kronovi24/Automated-Emergency-Power-Supply-Using-Solar-Energy-/Web app/panel/assets/img/emergency.png

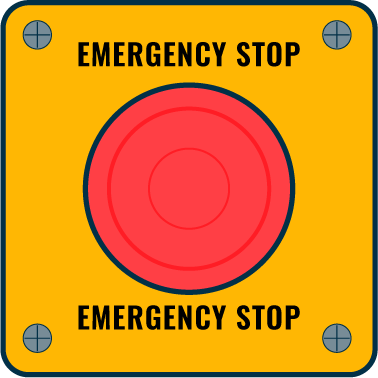
Web app/panel/assets/img/emergency.png
