kronovi24/Automated-Emergency-Power-Supply-Using-Solar-Energy-/Web app/panel/assets/img/smiley.jpg

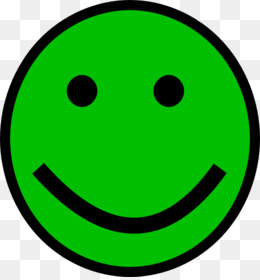
Web app/panel/assets/img/smiley.jpg
