kronovi24/Automated-Emergency-Power-Supply-Using-Solar-Energy-/Web app/panel/assets/img/swith2.jpg

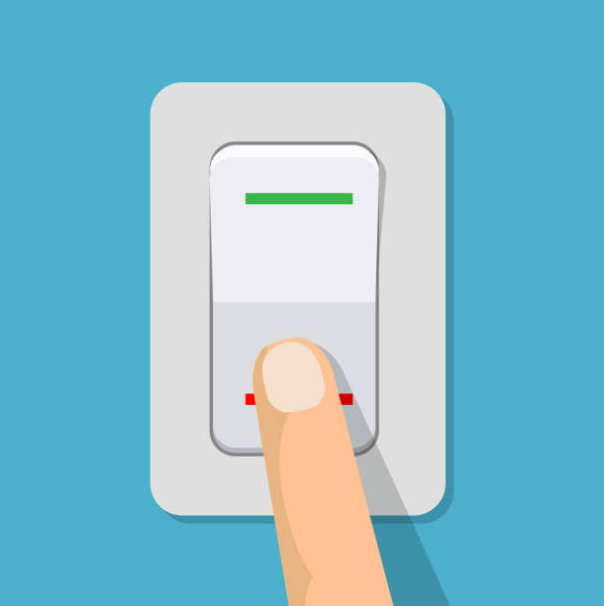
Web app/panel/assets/img/swith2.jpg
